SreeniEadara/PowerPi/ElectriPi.kicad_pcb

## KiCad design ElectriPi.kicad_pcb (2025-02-05)

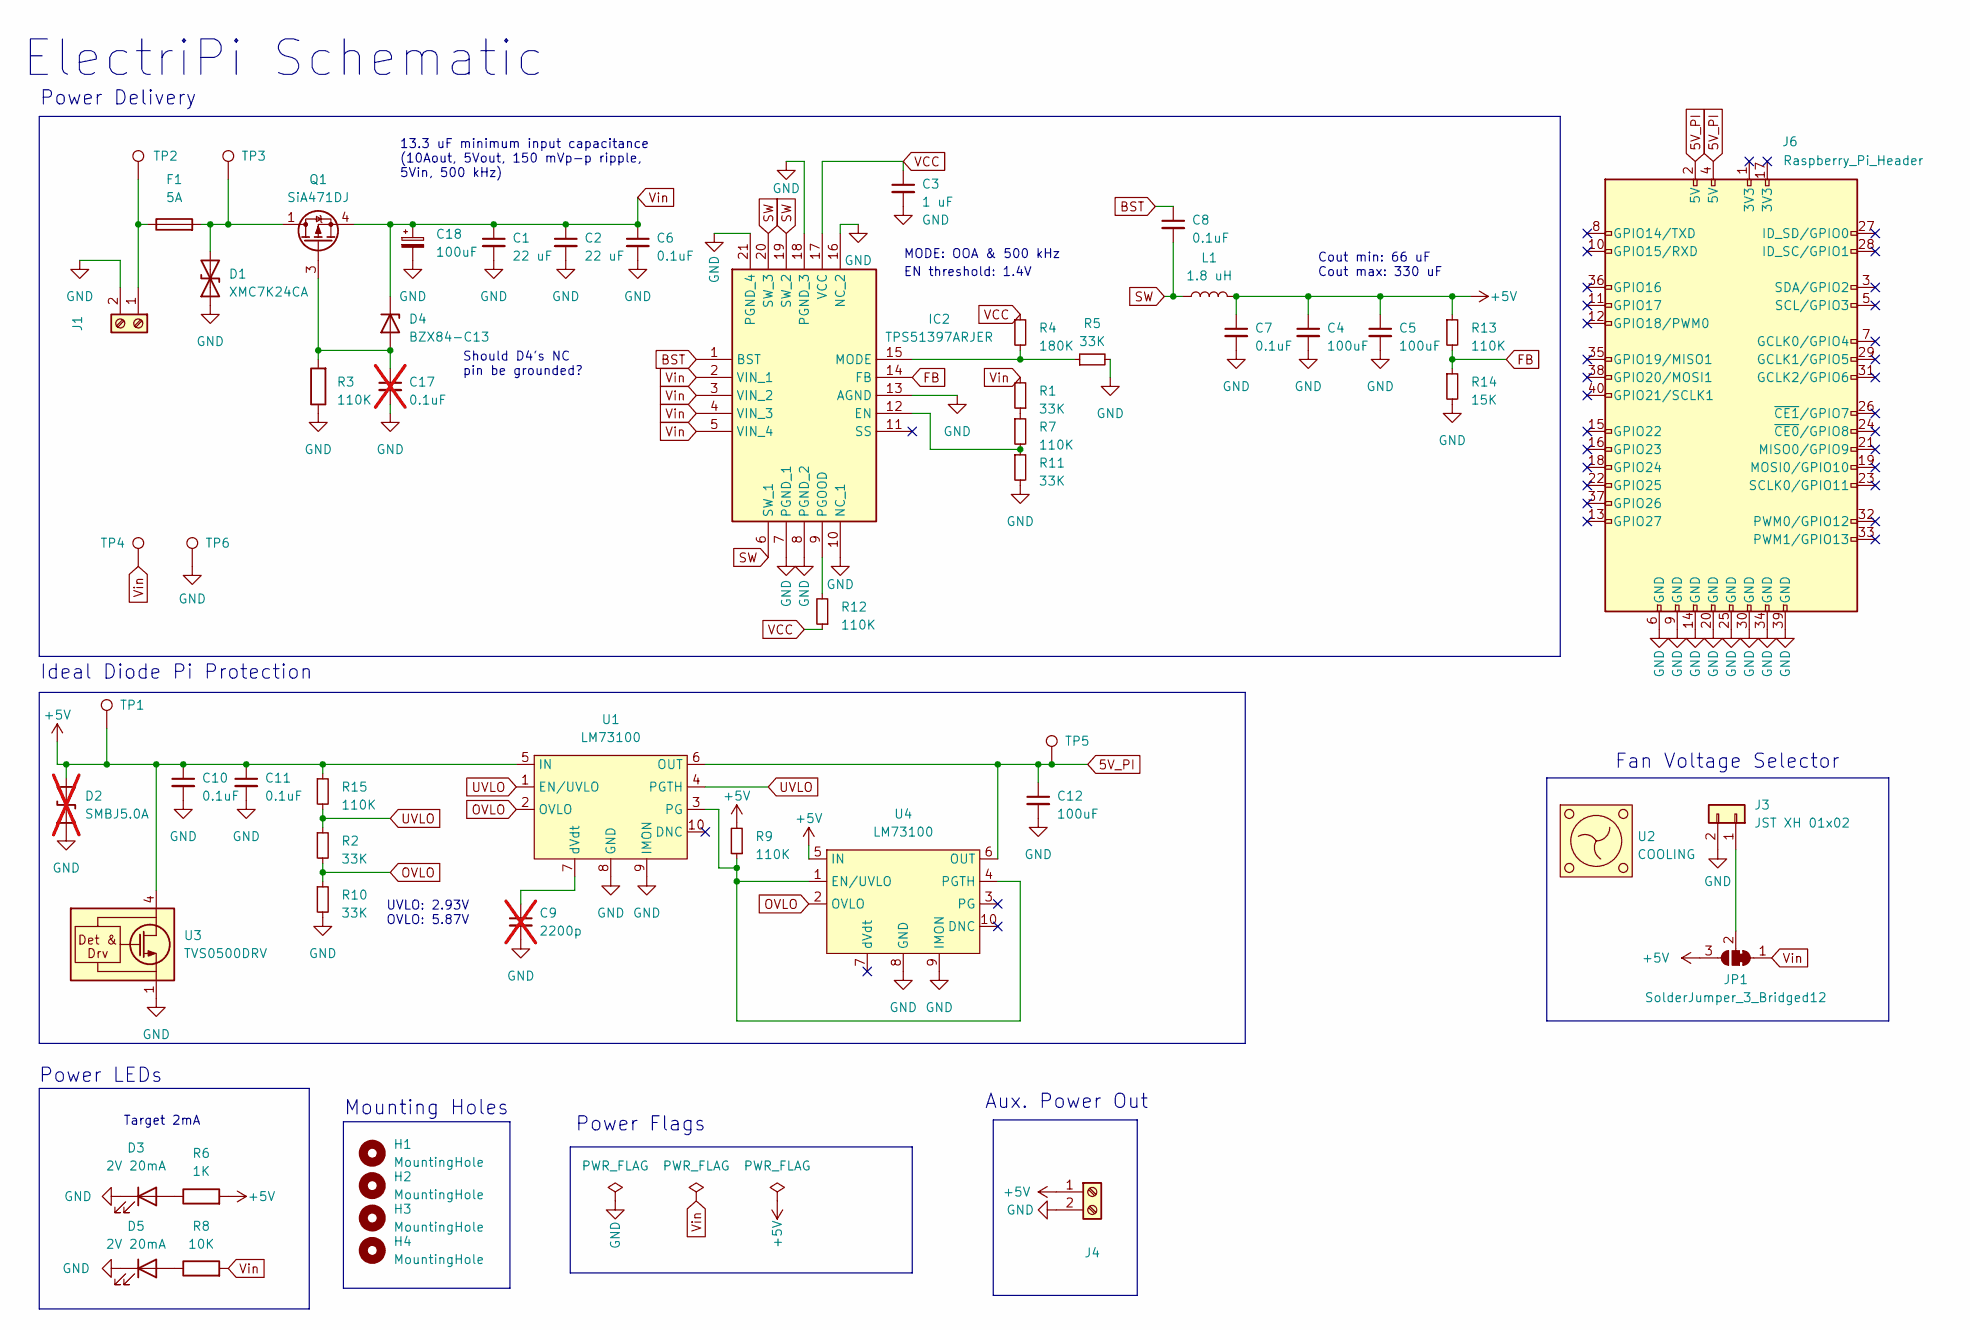
[picture p1: schematic ElectriPi.kicad_sch]

Parts:
C1, C2: 22 uF; C_0805_2012Metric; Mouser 810-C2012X5R1V226MAC
C3: 1 uF; C_0603_1608Metric; LCSC C15849
C4, C5, C12: 100uF; C_1206_3216Metric; Mouser 81-GRM31CR61A107MA8L
C6, C7, C8, C10, C11: 0.1uF; C_0402_1005Metric; Mouser 81-GRM155R62A104KE4J
C9: 2200p; C_0402_1005Metric; DigiKey 490-GCM155R71H222KA37JTR-ND; not fitted
C17: 0.1uF; C_0402_1005Metric; Mouser 81-GRM155R62A104KE4J; not fitted
C18: 100uF; CP_Elec_8x10; Mouser 80-EEV107M050S9MAA
D1: XMC7K24CA; D_SMC; Mouser 78-XMC7K24CAHM3/H
D2: SMBJ5.0A; D_SMB; DigiKey SMBJ5.0ALFTR-ND; not fitted
D3, D5: 2V 20mA; LED_0603_1608Metric; LCSC C72038
D4: BZX84-C13; SOT-23; Mouser 771-BZX84-C13-T/R
F1: 5A; Fuseholder_Blade_Mini_Keystone_3557; LCSC C352820
H1, H2, H3, H4: MountingHole; MountingHole_2.7mm_M2.5_DIN965_Pad
IC2: TPS51397ARJER; QFN-20-1EP_3x3mm_P0.45mm_EP1.6x1.6mm_ThermalVias; LCSC C1518754
J1, J3, J4: JST XH 01x02; JST_XH_B2B-XH-A_1x02_P2.50mm_Vertical; LCSC C24193
J6: Raspberry_Pi_Header; SSM-120-_-DV-BE; LCSC C22436166
JP1: SolderJumper_3_Bridged12; SolderJumper-3_P1.3mm_Bridged2Bar12_RoundedPad1.0x1.5mm
L1: 1.8 uH; L_Vishay_IHLP-4040; LCSC C506636
Q1: SiA471DJ; Vishay_PowerPAK_SC70-6L_Single; Mouser 78-SIA471DJ-T1-GE3
R1, R2, R5, R10, R11: 33K; R_0402_1005Metric; LCSC C323721
R3, R7, R9, R12, R13, R15: 110K; R_0402_1005Metric; LCSC C413107
R4: 180K; R_0402_1005Metric; LCSC C413110
R6: 1K; R_0402_1005Metric; LCSC C409028
R8: 10K; R_0402_1005Metric; LCSC C270371
R14: 15K; R_0402_1005Metric; LCSC C319837
TP1, TP2, TP3, TP4, TP5, TP6: TestPoint; TestPoint_Pad_D1.5mm
U1, U4: LM73100; Texas_VQFN-HR-10_2x2mm_P0.475mm; DigiKey 296-LM73100RPWRTR-ND
U2: COOLING; 4040
U3: TVS0500DRV; WSON-6-1EP_2x2mm_P0.65mm_EP1x1.6mm; DigiKey 296-48382-2-ND

Connections:
5V_PI: C12.1, J6.2 (5V), J6.4 (5V), TP5.1, U1.6 (OUT), U4.6 (OUT)
+5V: C4.1, C5.1, C7.1, C10.1, C11.1, D2.2 (A2), J4.1, JP1.3 (B), L1.2, R6.2, R9.2, R13.1, R15.1, TP1.1, U1.5 (IN), U3.4 (IN), U3.5 (IN), U3.6 (IN), U4.5 (IN)
BST: C8.1, IC2.1 (BST)
FB: IC2.14 (FB), R13.2, R14.1
GND: C1.2, C2.2, C3.2, C4.2, C5.2, C6.2, C7.2, C9.2, C10.2, C11.2, C12.2, C17.2, C18.2, D1.1 (A1), D2.1 (A1), D3.1 (K), D5.1 (K), IC2.7 (PGND_1), IC2.8 (PGND_2), IC2.10 (NC_1), IC2.13 (AGND), IC2.16 (NC_2), IC2.18 (PGND_3), IC2.21 (PGND_4), J1.2, J3.2, J4.2, J6.6 (GND), J6.9 (GND), J6.14 (GND), J6.20 (GND), J6.25 (GND), J6.30 (GND), J6.34 (GND), J6.39 (GND), R3.1, R5.2, R10.2, R11.2, R14.2, TP6.1, U1.8 (GND), U1.9 (IMON), U3.1 (GND), U3.2 (GND), U3.3 (GND), U3.7 (GND), U4.8 (GND), U4.9 (IMON)
unnamed: D1.2 (A2), F1.2, Q1.1 (D), TP3.1
unnamed: D3.2 (A), R6.1
unnamed: C17.1, D4.1 (A), Q1.3 (G), R3.2
unnamed: D5.2 (A), R8.1
unnamed: IC2.12 (EN), R7.2, R11.1
unnamed: IC2.15 (MODE), R4.2, R5.1
unnamed: IC2.9 (PGOOD), R12.2
unnamed: F1.1, J1.1, TP2.1
unnamed: J3.1, JP1.2 (C)
unnamed: R1.1, R7.1
unnamed: R9.1, U1.3 (PG), U4.1 (EN/UVLO), U4.4 (PGTH)
unnamed: C9.1, U1.7 (dVdt)
OVLO: R2.2, R10.1, U1.2 (OVLO), U4.2 (OVLO)
SW: C8.2, IC2.6 (SW_1), IC2.19 (SW_2), IC2.20 (SW_3), L1.1
UVLO: R2.1, R15.2, U1.1 (EN/UVLO), U1.4 (PGTH)
VCC: C3.1, IC2.17 (VCC), R4.1, R12.1
Vin: C1.1, C2.1, C6.1, C18.1, D4.3 (K), IC2.2 (VIN_1), IC2.3 (VIN_2), IC2.4 (VIN_3), IC2.5 (VIN_4), JP1.1 (A), Q1.4 (S), R1.2, R8.2, TP4.1

Notes on the sheet:
Ideal Diode Pi Protection
Mounting Holes
Target 2mA
MODE: OOA & 500 kHz
Fan Voltage Selector
Cout min: 66 uF Cout max: 330 uF
ElectriPi Schematic
13.3 uF minimum input capacitance (10Aout, 5Vout, 150 mVp-p ripple, 5Vin, 500 kHz)
EN threshold: 1.4V
Should D4's NC pin be grounded?
Aux. Power Out
Power Flags
Power LEDs
UVLO: 2.93V OVLO: 5.87V
Power Delivery

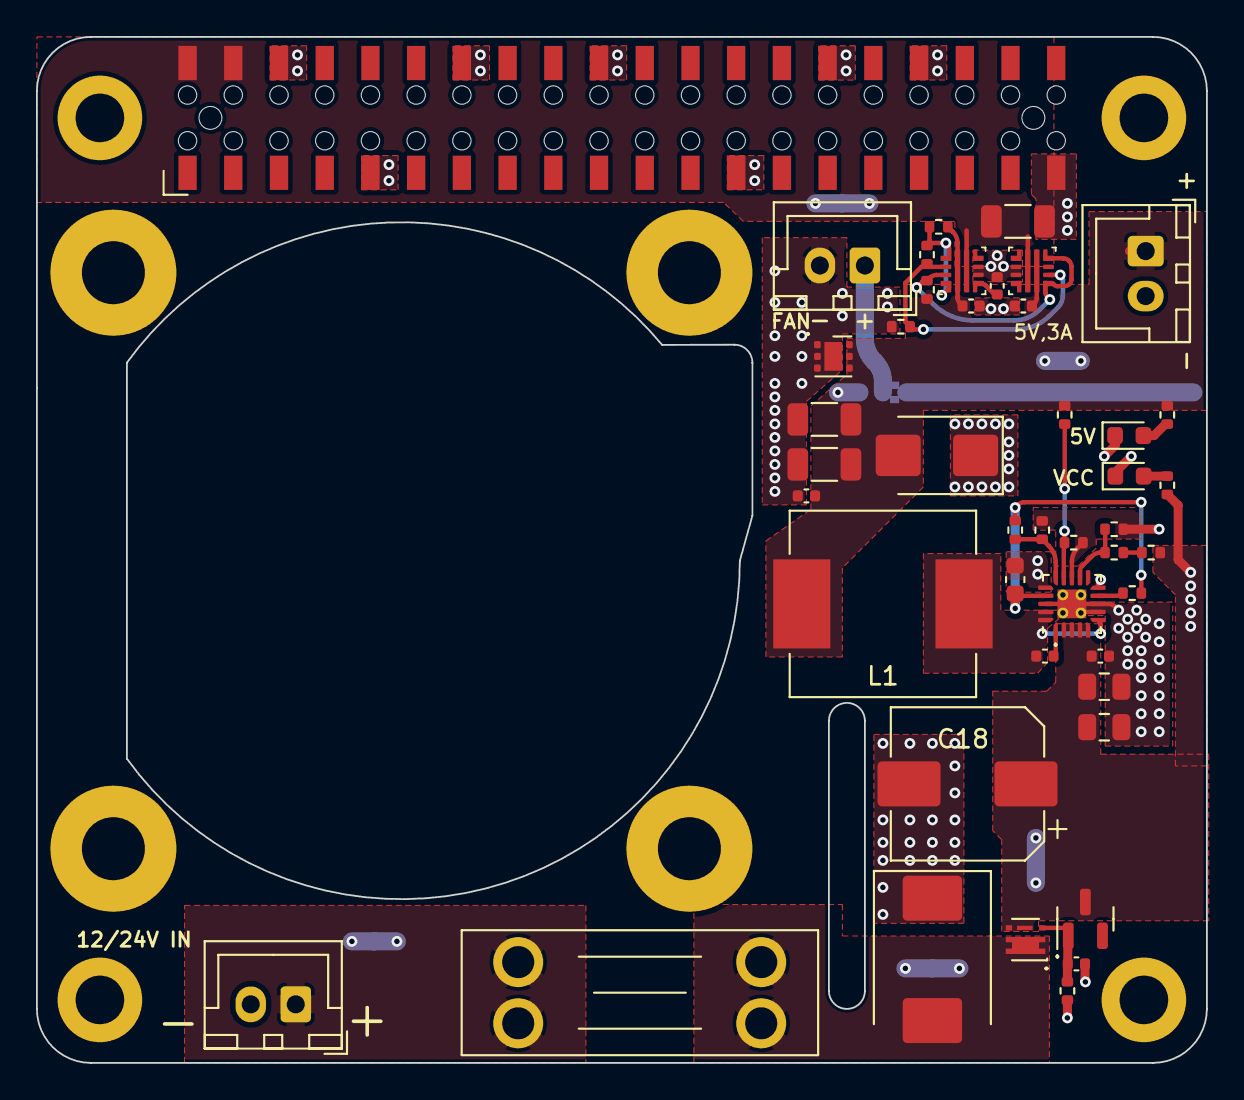
[picture p2: board ElectriPi.kicad_pcb from above]

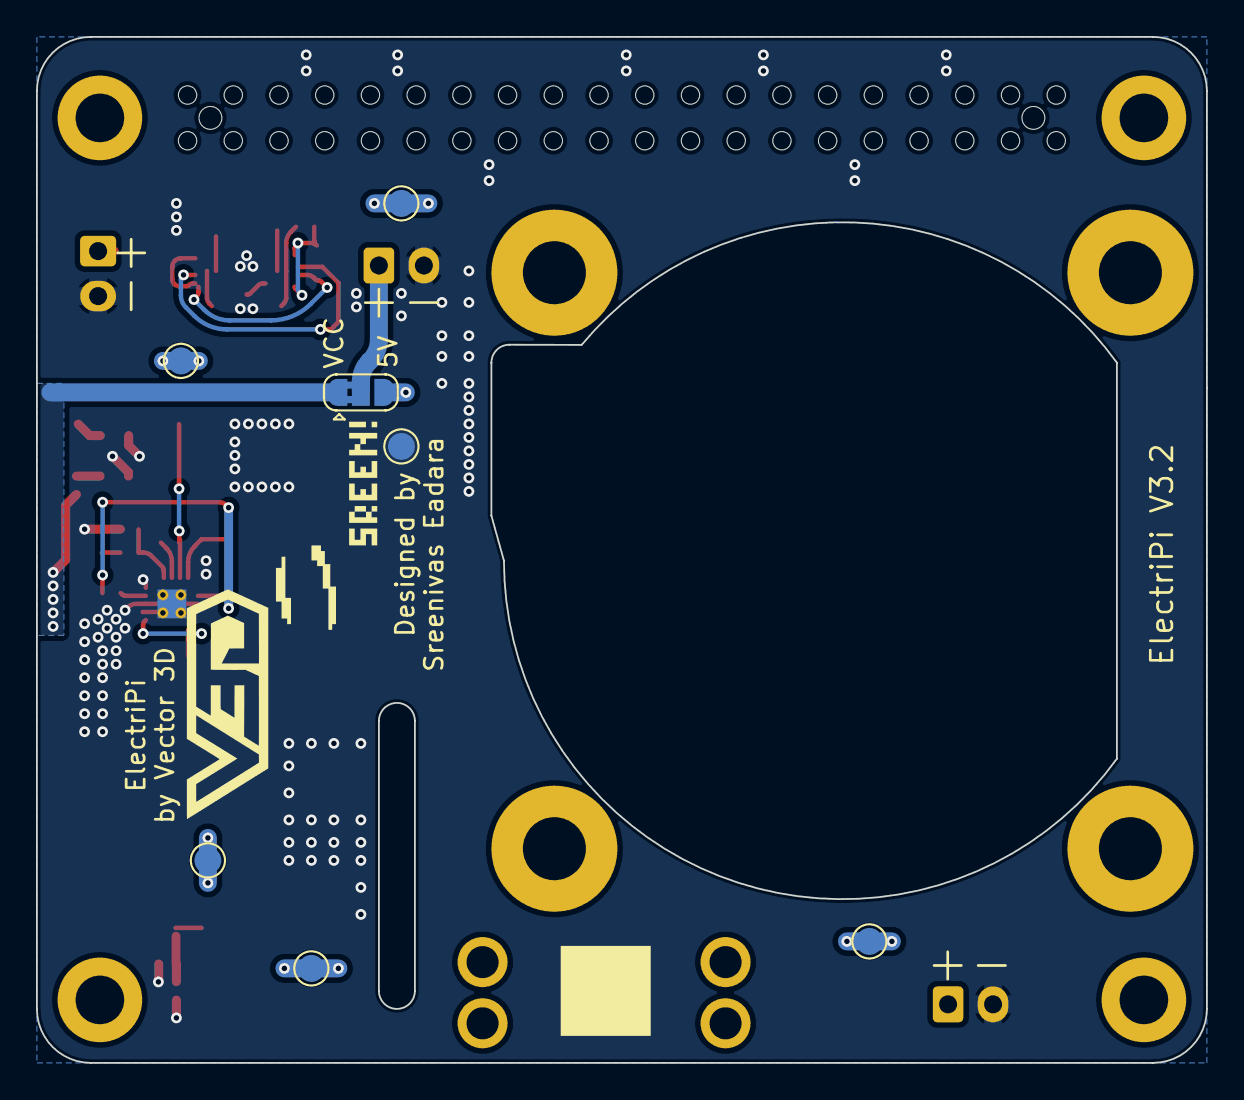
[picture p3: board ElectriPi.kicad_pcb from below]

Board: 2 copper layers, 65.0 x 57.0 mm, 57 parts (7 on the bottom side), 22 nets.
