SreeniEadara/PowerPi/(commit log)

2024-04-11 Fix silk bug for fan voltage select
    [ElectriPi.kicad_pcb]
2024-04-21 Enable 3D model creation locally
    [ElectriPi.kicad_pcb]
2024-05-03 Remove DNP on R9 and U4
    [ElectriPi.kicad_sch]
2024-05-03 Update PCB with BOM properties
    [ElectriPi.kicad_pcb]
2024-05-30 revert DNP on C5
    [ElectriPi.csv, ElectriPi.kicad_pcb, ElectriPi.kicad_sch]
2024-06-03 Re-export gerbers
    [ElectriPi-B_Cu.gbr, ElectriPi-B_Mask.gbr, ElectriPi-B_Paste.gbr, ElectriPi-B_Silkscreen.gbr, ElectriPi-Edge_Cuts.gbr, ElectriPi-F_Adhesive.gbr, ElectriPi-F_Cu.gbr, ElectriPi-F_Mask.gbr]
2024-12-15 Change to 40 pin passthrough header
    [ElectriPi.kicad_pcb, ElectriPi.kicad_sch]
2024-12-15 Change silk and test point position. Update manufacturing outputs. Header product number not yet specified
    [ElectriPi-B_Cu.gbr, ElectriPi-B_Mask.gbr, ElectriPi-B_Paste.gbr, ElectriPi-B_Silkscreen.gbr, ElectriPi-Edge_Cuts.gbr, ElectriPi-F_Adhesive.gbr, ElectriPi-F_Cu.gbr, ElectriPi-F_Mask.gbr]
2025-01-27 V1.1 Updates
    Moved status LEDs away from PCB edge.
    Moved and modified AUX 5V label.
    Changed screw terminals to JST XH.
    Added SMD Header LCSC number.
    Added 5mm silkscreen for QR Code
    Removed silkscreen border for 4010 fan.
    [BOM-ElectriPi.csv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]
2025-01-29 Corrected Version Number on Silk
    [ElectriPi-CuBottom.gbr, ElectriPi-CuTop.gbr, ElectriPi-EdgeCuts.gbr, ElectriPi-MaskBottom.gbr, ElectriPi-MaskTop.gbr, ElectriPi-NPTH.drl, ElectriPi-PTH.drl, ElectriPi-PasteBottom.gbr]
2025-02-05 Updated C1, C2, and C18
    Part no longer available or lower cost alternatives with same spec identified
    [BOM-ElectriPi.csv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]
